0422/DeskTalk/docs/2-外壳设计/各模块的step模型/0-96-oled-display-1.snapshot.1/0.96inch-OLED-Module-D-1.jpg

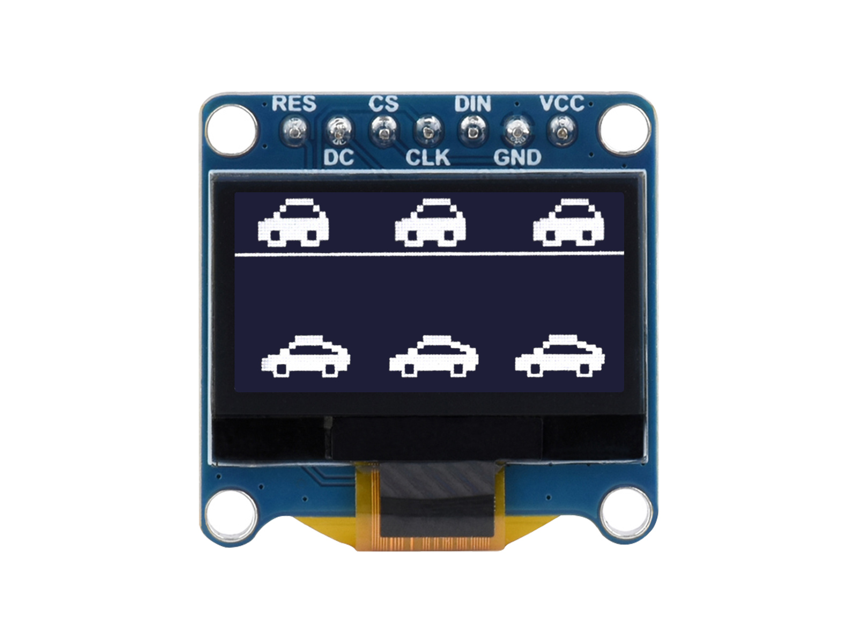
docs/2-外壳设计/各模块的step模型/0-96-oled-display-1.snapshot.1/0.96inch-OLED-Module-D-1.jpg
