0422/DeskTalk/docs/1-固件文档/README.md

# 固件文档

本目录包含 Desk-talk 各版本固件的详细设计说明、优化记录和测试数据。

## 📚 文档清单

| 文档 | 版本 | 框架 | 说明 |
|---|---|---|---|
| [V1说明.md](V1说明.md) | V1 | Arduino | 基础实现，已归档 |
| [V2说明.md](V2说明.md) | V2 | ESP-IDF | V2/desk_talk_idf 完整代码说明（含迁移、功能与测试） |
| [V3：端到端并行架构（规划中）.md](V3：端到端并行架构（规划中）.md) | V3 | ESP-IDF | 端到端并行架构（规划中） |
| [双芯片方案.md](双芯片方案.md) | - | ESP-IDF | ESP32-S3 + C6 双芯片方案架构分析 |

**说明**：
- **V1**：Arduino 框架基础实现，已归档
- **V2说明**：整合原 V2说明.md（功能实现与测试）和 V3说明.md（代码结构与迁移），完整描述 V2/desk_talk_idf 项目
- **V3**：端到端并行架构，规划中

## 🔄 版本总览

版本演进、框架与典型延迟详见 [版本历史.md](../版本历史.md)。

---

> 最后更新：2026-09-22
