0422/DeskTalk/docs/0-硬件文档/README.md

# 硬件文档

本目录包含 Desk-talk 机器人的硬件相关文档，包括物料清单、组装说明、接线图和模块测试。

## 📦 文档清单

| 文档 | 说明 |
|---|---|
| [材料清单.md](材料清单.md) | 物料清单（BOM），列出所有器件和规格 |
| [组装说明.md](组装说明.md) | 组装步骤与注意事项 |
| [接线说明.md](接线说明.md) | 杜邦线接线表（含 GPIO 引脚映射） |
| [模块说明.md](模块说明.md) | 各模块说明与功能测试方法 |

## 📎 附件

- **云台安装教程**：[attachments/0-金属二自由度云台安装教程.pdf](attachments/0-金属二自由度云台安装教程.pdf)
- **参考图片**：[attachments/](attachments/)

## 🔌 器件与引脚

完整器件规格见 [材料清单.md](材料清单.md)，逐线 GPIO 映射见 [接线说明.md](接线说明.md)。

**注意**：当前固件仅使用 INMP441 左声道单麦，右声道硬件已连接但未启用。

---

> 硬件设计基于 [uncle-mark/desk-emoji](https://github.com/uncle-mark/desk-emoji) 项目，感谢原作者。

---

> 最后更新：2026-09-22
