0422/DeskTalk/docs/2-外壳设计/README.md

# 外壳设计

本文档记录 Desk-talk 机器人的外壳结构设计、开孔位置和装配说明。

## 设计背景

在 V1 基础上继续设计与调整机器人外壳结构，以适配屏幕、摄像头、舵机、麦克风和扬声器等硬件布局。

## 结构说明

### 底板与顶板

- **底板 / 顶板**：均为矩形
- **四个角开孔**：孔心间距 76.08 mm，孔半径 1.5 mm

### 顶板居中新孔

1. **云台底座开孔**：长边孔心间距 43.74 mm，短边孔心间距 23.28 mm，孔半径 1.5 mm
2. **麦克风窗口**：10.20 × 10.20 mm
3. **功放露出窗口**：7.70 mm × 7.46 mm
4. **喇叭开孔**：开孔间距 45.5 mm，孔心 3.5 mm（⚠️ 开孔错误待修正）

## 关键器件

| 器件 | 规格 | 备注 |
|---|---|---|
| 喇叭 | 1635 腔体喇叭，20×40 mm，8Ω 2W | 注意正负极 |
| 云台 | 金属二自由度舵机云台 | SG90S × 2 |
| 结构板 | 打印结构板 / 切割亚克力板 | 暂未使用 |

## 待修正

- [ ] 喇叭开孔位置需重新设计（当前开孔有误）
- [ ] 亚克力板切割和装配验证

## 附件

- **STEP 模型**：[各模块的step模型/](各模块的step模型/)
- **FreeCAD 可视化**：[FreeACD组装可视化/](FreeACD组装可视化/)
- **参考图片**：[attachments/](attachments/)

---

> 最后更新：2026-09-22
