0422/DeskTalk/docs/0-硬件文档/接线说明.md

# 汇总说明

当前程序只会采集 L/R=GND 的左麦，右麦不会参与语音识别，可以只插一个麦克风，或修改程序使支持双麦。双麦共用 SD、WS、SCK 的接法本身正确，但并联不会自动获得降噪效果。
> 如果只是给 ASR 录音，建议暂时保留 ONLY_LEFT，使用一个声道最稳妥。
> 如果确实需要两个麦克风同时工作，则还要把输入改为立体声采集、按 INMP441 的 32 位槽读取，再将左右声道混合成 16 位单声道；ASR 当前声明的是单声道，不能只把 ONLY_LEFT 改成 RIGHT_LEFT 就结束。

| 器件 | 线 | ESP32-S3 底板连接 | **备注** |
| --- | --- | --- | --- |
| ==OLED== | GND | 任意 GND | |
| | VCC | 3V3 | |
| | SDA | IO8（GPIO 8） | |
| | SCL | IO9（GPIO 9） | |
| | | | |
| ==X轴舵机（左右）== | 橙/黄，信号 | IO12 的黄色 S 排 | |
| X轴舵机 | 红，电源 | 底板左下角标注 5V 的电源排，或独立 5V 电源 | |
| X轴舵机 | 棕/黑，地 | GND | |
| ==Y轴舵机（上下）== | 橙/黄，信号 | IO13 的黄色 S 排 | |
| Y轴舵机 | 红，电源 | 底板左下角标注 5V 的电源排，或独立 5V 电源 | |
| Y轴舵机 | 棕/黑，地 | GND | |
| | | | |
| ==INMP441 A（左麦）==  | VDD | 3V3 | 必须使用 3.3V 供电 |
| | GND | GND | 与 ESP32-S3、右麦和 MAX98357 共地 |
| | SD (DOUT)  | IO4 (GPIO4) | 与右麦的 SD 并联到同一个 GPIO4 |
| | WS (LRCLK) | IO5 (GPIO5) | 与右麦共用左右声道时钟 |
| | SCK (BCLK) | IO6 (GPIO6) | 与右麦共用位时钟 |
| | L/R | GND | 选择左声道，不能悬空 |
| | | | |
| ==INMP441 B（右麦）==  | VDD | 3V3 | 必须使用 3.3V 供电 |
| | GND | GND | 与 ESP32-S3、左麦和 MAX98357 共地 |
| | SD (DOUT)  | IO4 (GPIO4) | 与左麦的 SD 并联到同一个 GPIO4 |
| | WS (LRCLK) | IO5 (GPIO5) | 与左麦共用左右声道时钟 |
| | SCK (BCLK) | IO6 (GPIO6) | 与左麦共用位时钟 |
| | L/R | 3V3 | 选择右声道，不能悬空 |
| | | | |
| ==MAX98357 功放== | VIN | 5V | 接底板明确标注的 5V 接口 |
| | GND | GND | 与 ESP32-S3、INMP441 共地 |
| | DIN | IO7 (GPIO7) | ESP32-S3 音频数据输出，功放数据输入 |
| | BCLK | IO17 (GPIO17) | 位时钟 |
| | LRC | IO18 (GPIO18) | 左右声道时钟 |
| | GAIN | 悬空或接 MAX98357 的 VIN (5V)  | 悬空为 9 dB；接 VIN (5V) 为 6 dB，不要接 3.3V |
| | SD | GPIO3 | 悬空通常也会保持使能， |
| | | | |
| ==喇叭== | 正极 (+) 红色线 | MAX98357 的 OUT+ | 功放差分输出 |
| | 负极 (-)黑色线  | MAX98357 的 OUT- | 不得接 GND |
| | | | |
| ==PAJ7620U2 手势追踪== | VCC | 3V3 | 还没买，待验证 |
| | GND | GND | |
| | SDA | IO1 (GPIO1) | |
| | SCL | IO2 (GPIO2) | |
| | INT | 悬空，不连接 | |

## ESP32-S3 直连方案
（单麦、无手势追踪），需要从 ESP32-S3 底板上引出的电源数量如下：

| 设备 | 数量 |
|---|---|
| OLED VCC | 1 |
| INMP441 VDD | 1 |
| 合计 | 2 个 3V3 |
两个都是低功耗，ESP32-S3 底板通常只有 **1 个 3V3 排针**，所以你需要**一拖二**，从 3V3 分给 OLED 和单麦。

| 设备 | 数量 | 是否建议走底板 5V |
|---|---|---|
| MAX98357 VIN | 1 | 可以，功放电流中等  |
| X 轴舵机 | 1 | 不建议 |
| Y 轴舵机 | 1 | 不建议 |
| 合计 | 3 个 5V |
底板通常也只有 **1 个 5V 排针**。如果三个都从底板 5V 一拖三：
- MAX98357 功放：中等电流，问题不大
- 两个 MG90 舵机：同时动可能 1A+，**底板 5V 和 USB 供电扛不住**，容易复位

```file:推荐接法
底板 3V3 → 一拖二 → OLED VCC
                  → INMP441 VDD

底板 5V → MAX98357 VIN（功放单独走底板）
独立 5V 电源 → 一拖二 → X 轴舵机红线
                     → Y 轴舵机红线
              └→ GND 与 ESP32 共地
```

| 线 | 用途 | 数量 |
|---|---|---|
| 一拖二杜邦线（母对母） | 3V3 分给 OLED + 麦 | 1 根 |
| 一拖二杜邦线（母对母） | 独立 5V 分给两个舵机 | 1 根 |
| 普通杜邦线 | 5V 给功放 | 1 根 |
| GND 一拖多 | 所有设备共地 | 建议用面包板电源轨 |
