0422/DeskTalk/docs/待开发计划.md

# 今日开发

## 2026-09-22 本轮完成与验证结论

- ✅ `main/llm_client.cpp` 已支持硬标点即时分句，短句不再等待完整 LLM 输出。
- ✅ `main/tts_client.cpp` 已支持句子队列短暂背压、TTS TCP keepalive，以及会话内物理 WebSocket 复用。
- ✅ 多轮日志已出现 `Persistent bidirectional connection reused`，说明 TTS 复用在后续轮次实际生效。
- ⚠️ `400 ms` 静音阈值短停顿测试出现多次前半句截断，已恢复为 `500 ms`；`400 ms` 配置保留为注释供后续对照。
- ⚠️ `session=30` 和 `session=32` 出现 ASR 空结果/串行重试，不能计入正常延迟基线。
- ⏳ LLM HTTPS 长连接仍未实现，当前仍是每轮重新建立 HTTPS 连接。

本轮短停顿日志（`session=22~32`）显示：首轮包含 TTS 预热，后续正常轮次约 `2.2~2.8 s`；重试轮次的延迟按无效样本处理。代码已完成修改，硬件重新编译与烧录由后续测试执行。

---

# 待实现计划
本文档汇总 Desk-talk 当前已知问题、待实现功能和技术债。

---

## 🔴 高优先级

### 1. TTS 连接复用（部分实现）

**问题**：当前每轮对话重建 TTS WebSocket，约 0.6–0.8 秒建连开销。  
**目标**：常驻 TTS 连接，预期降低 ~0.7 秒/轮。  
**当前状态（V2）**：
- ✅ V2 已实现 V3 双向 Session + Session 级物理 WebSocket 复用
- ✅ 唤醒后建立会话级 TTS 连接，后续轮次日志已确认复用成功
- ⚠️ 内部 RAM 水位仍然很低；ASR 空结果、连接异常或会话结束时会释放 TTS 并串行重试
- ⚠️ 复用的是物理 WebSocket，TTS 业务 Session 仍按回答重新开始

**剩余工作**：
- [ ] 评估 ESP-IDF mbedTLS 外部内存 + PSRAM 优化空间，降低复用期间的内存风险
- [ ] 或启用流式网关（仅 V1 工程有实现，V2 未移植），将 TLS 内存压力移至服务器
- [ ] 继续处理 ASR 空结果时的 TTS 释放/重连，减少 `asr_retries=1` 样本
- [ ] 优先解决双 TLS 内存水位问题（测试中 `internal_min` 约为几十字节）

**参考**：[V2说明.md 板载 TLS 内存限制](1-固件文档/V2说明.md#板载-tls-内存限制)

### 2. LLM HTTPS 长连接

**问题**：DeepSeek 每轮从零建连，含 DNS/TCP/TLS 握手约 0.3–1 秒。  
**目标**：复用 HTTP 连接，省去握手开销。  
**当前状态（V2）**：
- ❌ V2说明.md §HTTPS 长连接与双 TLS 危机：LLM 每轮从零建连，无连接复用
- 每轮 `chat()` 执行 `init → perform → cleanup`，无连接复用

**待实现**：
- [ ] 修改 `llm_client.cpp` 设置 `keep_alive_enable=true`
- [ ] handle 提升为成员变量跨轮复用，仅传输错误时重建
- [ ] 验证内部 RAM 水位：常驻 LLM + 常驻 TTS 双连接是否可行

**预期收益**：每轮节省 ~0.5 秒（握手开销）

### 3. VAD 句尾截断验证

**问题**：静音阈值过短可能导致用户短暂停顿被误判为结束。
**目标**：在短停顿场景（如"嗯……"、"就是"）验证识别完整性。  
**方案**：
- [x] 完成一轮 `400 ms` 短停顿试验（`session=22~32`）
- [x] 发现多次前半句截断，确认 `400 ms` 不满足当前拾音条件
- [x] 已将 `main/asr_client.cpp` 恢复为 `500 ms`
- [ ] 使用恢复后的 `500 ms` 再完成 20 轮短停顿 ASR 测试
- [ ] 对比 ASR 最终文本与预期，统计截断率；目标不超过 `5%`

---

## 🟡 中优先级

### 4. 摄像头人脸跟随（已处理，当前禁用）

**现状**：硬件已支持（GC2145 摄像头），V2 明确保持禁用，原因：
- 主 loop 同步推理会阻塞网络任务（500ms/帧）
- 当前固件已验证无需摄像头即可正常运行

**目标**：恢复人脸检测 + 头部跟随，并解决主循环阻塞问题。  
**重新激活前提**：
- [ ] 将 `handle_face_tracking()` 改为独立 FreeRTOS 任务或降低推理频率
- [ ] 验证并发写 GPIO12/13 的舵机抖动问题
- [ ] 验证无人脸时 `random_act()` 能否正常触发（V1 审查"空闲头部僵住"问题）

### 5. 手势传感器（已处理，当前禁用）

**现状**：PAJ7620U2 硬件已列入物料清单，V2 明确保持禁用。代码中有开关但未验证，原因：
- I2C 引脚占用（GPIO1/2）需确认是否与现有外设冲突
- Arduino 库 `RevEng PAJ7620` 在 ESP-IDF 下的兼容性未验证

**目标**：支持 9 种手势识别触发动作。  
**待验证**（重新激活前）：
- [ ] I2C 引脚占用（GPIO1/2）是否与现有外设冲突
- [ ] 在 ESP-IDF 下验证 `RevEng PAJ7620` 库兼容性

### 6. 双麦拾音优化

**现状**：仅使用 INMP441 左声道，右声道并联但未使用。  
**目标**：实现立体声采集 + 软件下混，改善拾音距离和信噪比。  
**方案**：
- [ ] 改为 I2S 立体声模式（`I2S_CHANNEL_FMT_RIGHT_LEFT`）
- [ ] 32-bit 原始数据右移 16 位转 16-bit PCM
- [ ] (L + R) / 2 下混或选择信噪比更优的单声道
- [ ] 实测校准左右声道增益

---

## 🟢 低优先级 / 未来探索

### 7. 配置类功能（多 LLM / 多唤醒词 / 情感驱动动作）

**目标**：支持切换 LLM 供应商、动态增删唤醒词、按情感自动匹配表情动作。  
**状态**：方案细节与代码位置见 [1-固件文档/V2说明.md §待实现功能](1-固件文档/V2说明.md#待实现功能)，此处不再重复。

### 8. 本地离线 TTS

**目标**：断网时仍能回复，降低云端依赖。  
**方案**：
- [ ] 集成 sanoTTS（int8 模型 337 KB，RTF 0.38）
- [ ] 预录音色包（高频应答短语）
- [ ] 网络检测 + 自动降级路由

### 9. LED 亮度自适应

**现状**：WS2812 固定亮度，暗室刺眼。  
**目标**：根据环境光（光敏电阻）或时间自动调节亮度。

---

## 📋 已知技术债

| 问题 | 位置 | 严重性 | 状态 | 备注 |
|---|---|---|---|---|
| 串口日志 256 字节截断中文 | `common.h` 日志器（V1 路径） | 低 | ✅ 已解决（V1） | V1 改为直接输出完整 `String` |
| 舵机并发写抖动 | `act.cpp` + `face_tracking.cpp`（V1 路径） | 中 | ⚠️ 待确认 | V2 未明确提及，舵机功能正常，人脸跟随时需验证 |
| ASR WebSocket 关闭时非致命警告 | `asr_client.cpp` | 低 | ⚠️ 待优化 | 当前判断为关闭握手噪声，可过滤但不影响功能 |
| ASR 空结果触发 TTS 释放/串行重试 | `conversation.cpp` | 中 | ⚠️ 待观察 | `session=30`、`32` 出现空结果；重试成功时不纳入正常延迟基线 |
| 空闲头部僵住（已录入 owner 时） | `face_tracking.cpp:207`（V1 路径） | 低 | ⚠️ 待确认 | V2 摄像头禁用时不适用，恢复人脸跟随后需验证 |
| mbedTLS 工作内存进入 PSRAM | `sdkconfig` | 中 | ⚠️ 待评估 | 正式产品需结合 Flash encryption、Secure Boot 评估 |

---

## 📅 近期里程碑

- [x] **2026-09**：V2 ESP-IDF 迁移完成，8 轮连续对话 + 20 轮延迟统计测试通过
- [x] **2026-09-22**：句子级 LLM→TTS 流式发送、TTS 物理 WebSocket 复用和延迟分阶段日志完成
- [x] **2026-09-22**：完成 `400 ms` VAD 对照测试并确认回退到 `500 ms`
- [ ] **2026-09-22 后续**：完成恢复 `500 ms` 后的 20 轮短停顿复测
- [ ] **2026-Q4**：TTS 连接复用内存优化（双 TLS 共存验证）
- [ ] **2026-Q4**：V3 端到端并行流水线实现（LLM 流式 + 首句触发 TTS）
- [ ] **2027-Q1**：摄像头 + 手势传感器集成（需解决主循环阻塞和引脚冲突）
- [ ] **2027-Q2**：双麦拾音优化 + 本地 TTS 降级

---

> 最后更新：2026-09-22  
> 优先级由项目维护者根据实际使用场景动态调整
