0422/DeskTalk/docs/1-固件文档/V1说明.md

> 备注：因 V2 迁移至 ESP-IDF 框架，V1 版本不再进行修改。

# V1 修改汇总

### 模块开关

原程序只有手势传感器能把 `start_chat` 设置为 true，现在改为了通过唤醒词开启对话。
> 未买入手势追踪模块，将程序中的手势触发停用了，可以通过宏打开。
> 且为方便各模块测试，对麦克风、摄像头、功放、手势追踪等均加了开关，
> 以及某个模块未插到开发板上时，启动时会跳过其初始化环节。

### 离线唤醒词

唤醒识别完全在 ESP32-S3 本地完成，但唤醒后的 ASR、LLM、TTS 仍走现有云端流程。
> 当前流程是半双工的"先听、再回答"，不需要回声消除。
> 若后续要求在机器人说话时也能用语音打断，则需要增加播放中录音、声学回声消除和新的对话状态机。

Arduino ESP32 3.0.0 自带的 WakeNet 模型固定选择 `hi esp`，不能只修改日志文字就变成自定义唤醒词。
改为使用 ESP-SR 自带的英文 MultiNet 命令检测，并把默认的 Hi ESP 短语和新增的唤醒词短语注册为同一个命令。
> MultiNet 自定义命令不是专门训练的 WakeNet 模型，短语识别效果和抗误唤醒能力可能与 ESP-SR 固定的 WakeNet 模型不同。

增加本地唤醒词 `Hi ESP` 和 `Hi Della`，唤醒后进入最长 10 分钟的连续对话窗口，避免每一轮对话都要重新唤醒。
> 唤醒后，主程序会暂停本地 MultiNet，避免它和云端 ASR 同时读取同一个 I2S 麦克风；
> 云端 ASR 结束后再恢复 MultiNet。
> 恢复时会清空待处理事件，并加入短暂冷却时间，避免上一段语音残留导致重复唤醒。

### DeepSeek 直连与多轮对话

- LLM 从第三方中转站迁移到 DeepSeek 官方 `https://api.deepseek.com/chat/completions`，使用 `deepseek-flash` 模型，减少中转服务不可达导致的连接失败。
- 请求使用非流式 JSON 输出、关闭思考模式并限制最大输出长度；回复从 `choices[0].message.content` 中解析。
- 对网络传输错误、HTTP 408、429 和 5xx 响应增加最多 3 次重试。
- ESP32-S3 在 SPIFFS 的 `/chat_history.json` 中保存上下文，每次请求携带系统提示词、历史用户/助手消息及本轮问题，实现多轮对话。
- 历史记录最多保留 10 轮、限制为 16 KiB；无效、不完整或过大的历史文件会自动重置。
- DeepSeek 密钥改由被 Git 忽略的 `secrets.h` 提供，并增加 `secrets.example.h`，不再把旧中转站密钥写在业务源码中。

### TTS 长回复与音频播放

- TTS WebSocket 回调只复制并排队 PCM，由独立 FreeRTOS 任务执行阻塞式 I2S 播放，防止播放过程阻塞后续网络收包。
- 有 PSRAM 时使用 48 个 PCM 队列槽，无 PSRAM 时使用 8 个；队列分片使用独立内存，播放后及时释放。
- 将长回复按完整句子拆为不超过约 120 个 UTF-8 字节的小段并逐段合成，切分时不破坏中文字符，避免服务端只生成长文本前半部分。
- 服务端在收到 PCM 后正常关闭连接时按流结束处理，并在播放队列完全排空后结束，不再把正常关闭误判为失败。
- 多段播放期间保持 MAX98357 功放开启；整条回复结束后等待 I2S DMA 中最多约 512 ms 的剩余音频播放完再静音，修复段尾吞字。
- 修正成功收到 PCM 时仍输出 `returned no PCM audio` 的错误判断，并记录每段文本长度、PCM 字节数和待播放分片数。

### 动作数量与舵机稳定性

- 删除 TTS 播放期间每 3 秒触发的随机语音动作，避免动作任务频繁打断音频和网络处理。
- 提示词将每次回复动作减少为 2～3 个，执行端再硬限制最多执行 3 个动作。
- 空闲随机行为不再自动驱动左右舵机，只保留不会抢占头部控制权的表情行为，降低底部舵机长时间通电后连续旋转的概率。
- 对话期间暂停人脸跟随，完成 ASR、LLM、动作和 TTS 后再恢复，避免多个功能同时控制头部舵机。

### Wi-Fi 连接与配网

- Wi-Fi 凭据优先保存到 NVS，并保留 SPIFFS 配置文件作为旧版本迁移和兼容备份；断线后在主循环中非阻塞重连。
- 配网模式明确使用 `WIFI_AP_STA`，使 `Desk-Emoji`（配网热点名）和附近网络扫描能够同时工作。
- 检查 SoftAP 启动结果及 `192.168.4.1` 地址；扫描失败时清理状态并自动重试一次，不再把扫描错误显示成"未找到网络"。
- 扫描接口增加错误码日志和合法 JSON 转义，网页能显示真实扫描失败原因。
- 默认联网目标改为开放网络 `Longemont`，密码为空；启动连接、断线重连和 NVS 保存均支持无密码 Wi-Fi。

### 串口日志与诊断

- `Bot:` 回复改为直接输出完整 `String`，绕过原日志器 256 字节格式化缓冲区，解决中文 JSON 在串口中只显示前半段并以乱码字符结尾的问题。
- Wi-Fi 日志增加 SSID、连接状态名称、SoftAP 地址和扫描结果；ASR、TTS 日志增加连接尝试、超时、PCM 接收量及播放完成状态，方便区分公网故障、服务端断开与本地播放问题。
- 对 ASR WebSocket 增加连接重试、超时和连接状态日志，能够区分 Wi-Fi 断开与云端 TLS/WebSocket 握手失败。

## 延迟基线说明

V1 阶段的延迟测量主要关注"说完话后到首音频播放"的端到端延迟，使用 `latency_trace` 记录 9 个阶段时间戳。

**典型耗时范围**（V1 初期样本）：
- `AUDIO_UPLOAD_DONE → PLAYBACK_START`：约 2.47–2.76 秒
- ASR 最终结果：约 0.11–0.29 秒
- LLM 首字节：约 0.55–1.13 秒
- TTS 建连：约 0.63–0.67 秒
- TTS 首 PCM：约 0.29–0.40 秒

**优化后**（V1 后期优化实施后）：
- VAD 静默等待：900ms → 650ms → 500ms
- DeepSeek 改为 SSE 增量接收
- TTS 独立播放任务 + PCM 队列
- 可选流式网关（默认关闭）
- 典型说完后延迟：约 2.377–2.874 秒

**关键瓶颈**：
- TTS 每轮新建 WebSocket，约 0.6–0.8 秒建连开销
- LLM 等待完整 JSON 后才触发 TTS
- 云服务生成和网络抖动

**迁移 ESP-IDF 预期**：
- 纯框架迁移可降低约 50–200 ms
- 结合连接复用和流水线优化可达到约 1.3–1.8 秒
- 稳定低于 1 秒需本地 ASR / WebRTC 类方案

## 移至 V2/V3 的功能

以下功能在 V1 阶段未完成或仅部分实现，移至后续版本：

- [x] **V2**：ESP-IDF 框架迁移（任务调度、PSRAM、mbedTLS 优化）
- [x] **V2**：TTS V3 双向接口 + 连接复用
- [x] **V2**：LLM 流式输出（SSE 增量接收）
- [ ] **V3**：首句立即触发 TTS + 端到端并行流水线（LLM 生成与 TTS 合成重叠）

## 待优化方向（V1 阶段提出，后续持续跟进）

1. **音频流控和流水线**：实现 LLM 流式输出 + 首句触发 TTS
2. **连接复用**：TTS WebSocket 长连接 + LLM HTTPS 长连接
3. **传输协议评估**：MQTT+UDP（低延迟弱网差）vs WebSocket（稳定）
4. **本地降级**：断网时离线命令识别 + 本地 TTS
5. **多唤醒词配置化**：动态增删无需重新编译

---

> 本文档已精简；V2 的测试数据与延迟拆解见 [V2说明.md](V2说明.md)。
> 原 Arduino 工程目录：`V1/Arduino_esp32s3_v0.0.1/Arduino_esp32s3_v0.0.1/`
> 最后更新：2026-09-22
