0422/DeskTalk/docs/0-硬件文档/attachments/ChatGPT Image 2026年9月8日 15_35_54.png

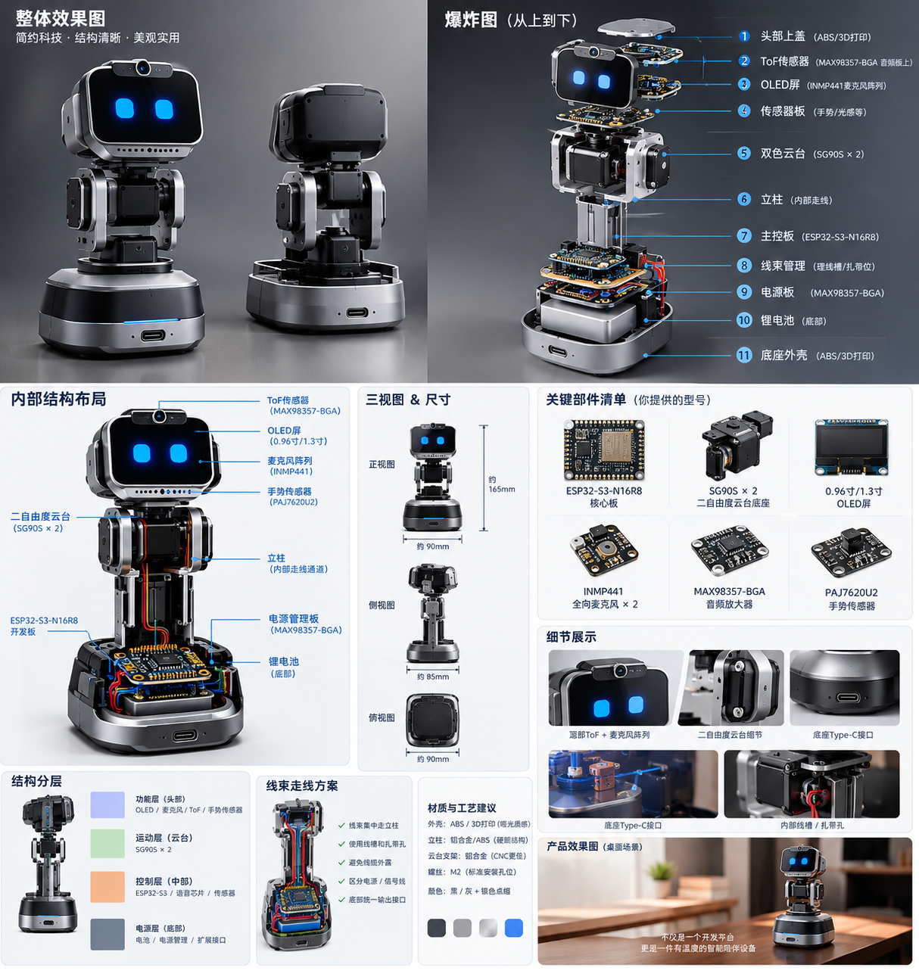
docs/0-硬件文档/attachments/ChatGPT Image 2026年9月8日 15_35_54.png
