0422/DeskTalk/docs/0-硬件文档/attachments/Pasted image 20260820151540.png

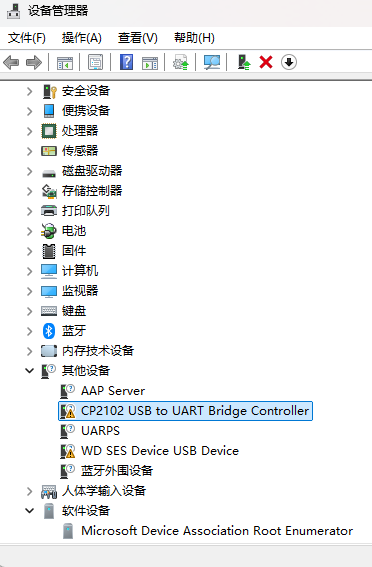
docs/0-硬件文档/attachments/Pasted image 20260820151540.png
