0422/DeskTalk/docs/0-硬件文档/attachments/Pasted image 20260912190659.png

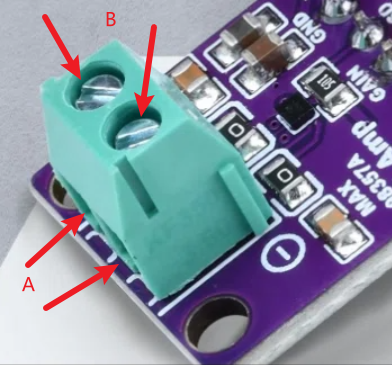
docs/0-硬件文档/attachments/Pasted image 20260912190659.png
