0422/DeskTalk/docs/2-外壳设计/attachments/acrylic_plates_cad_preview.png

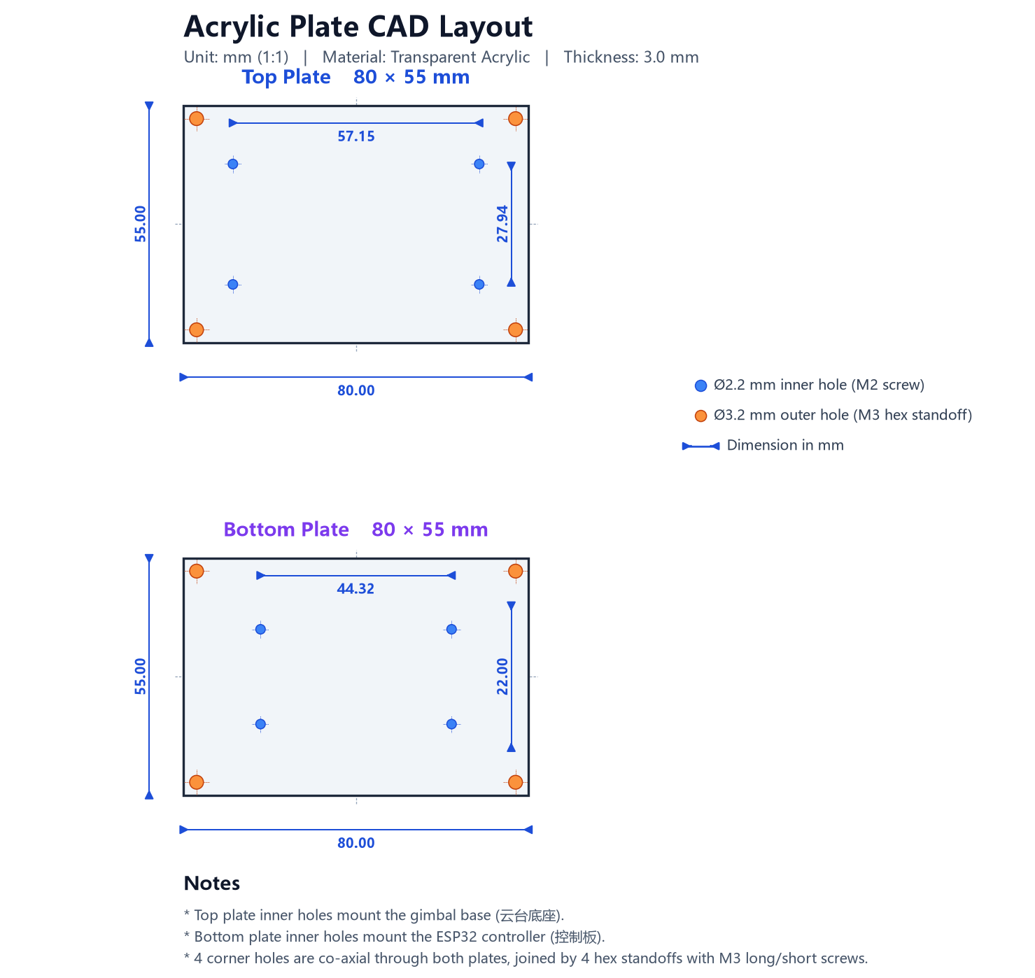
docs/2-外壳设计/attachments/acrylic_plates_cad_preview.png
