0422/DeskTalk/docs/2-外壳设计/attachments/Pasted image 20260916230812.png

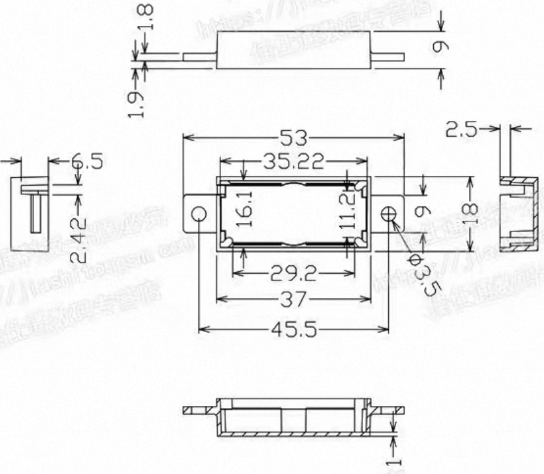
docs/2-外壳设计/attachments/Pasted image 20260916230812.png
