0422/DeskTalk/docs/0-硬件文档/材料清单.md

【已使用】
ESP32-S3-N16R8
ESP32-S3 GPIO Extension Board
INMP441全向麦克风
MAX98357-BGA音频放大器
2W 8欧 喇叭

金属二自由度云台（舵机 `SG90S` * 2 ）
OLED 屏，0.96 寸/1.3 寸
杜邦线若干

---
【暂未使用】
打印结构板/切割亚克力板
手势传感器  PAJ7620U2
摄像头模块 TX-G 2145-V 1.0

## 参考文档

- **云台组装**：见 [attachments/0-金属二自由度云台安装教程.pdf](attachments/0-金属二自由度云台安装教程.pdf)
- **接线说明**：[接线说明.md](接线说明.md)
- **模块测试**：[模块说明.md](模块说明.md)
- **烧录流程**：[../3-开发流程/烧录说明.md](../3-开发流程/烧录说明.md)

---

> 最后更新：2026-09-22
