0422/DeskTalk/docs/2-外壳设计/各模块的step模型/舵机云台/舵机云台_爱给网_aigei_com/舵机云台/舵机卡.SLDASM

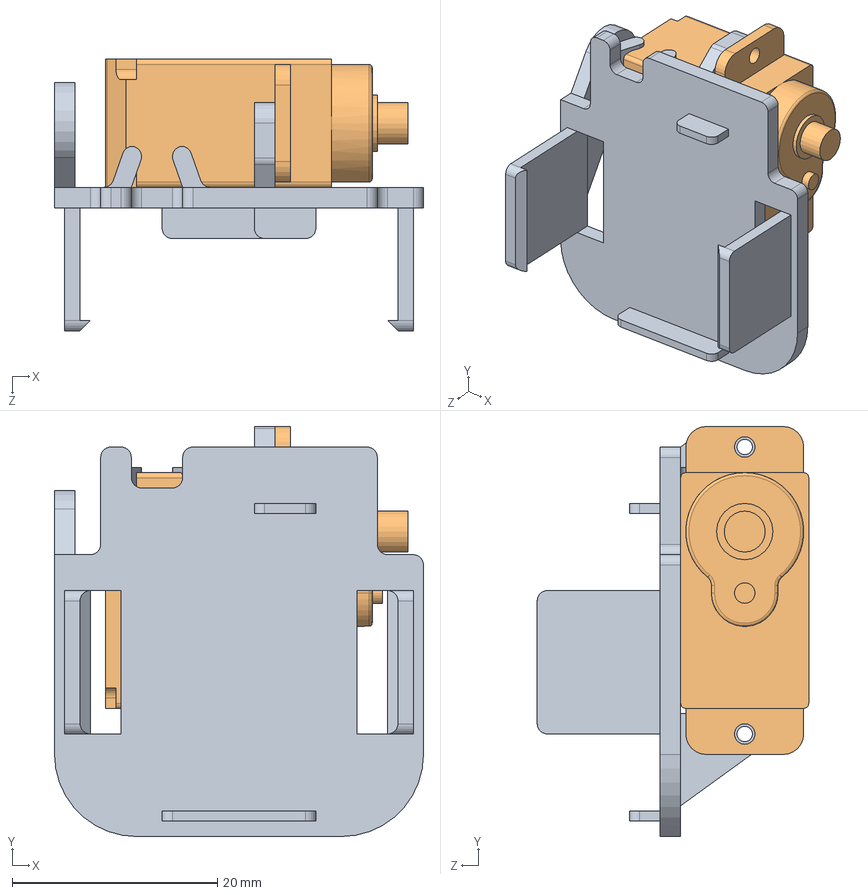
[picture p10: CAD file, 2026-09-18]
docs/2-外壳设计/各模块的step模型/舵机云台/舵机云台_爱给网_aigei_com/舵机云台/舵机卡.SLDASM
36.0 x 40.0 x 26.5 mm
卡壳
9G舵机
