0422/DeskTalk/docs/2-外壳设计/各模块的step模型/舵机云台/舵机云台_爱给网_aigei_com/舵机云台/舵机云台.SLDASM

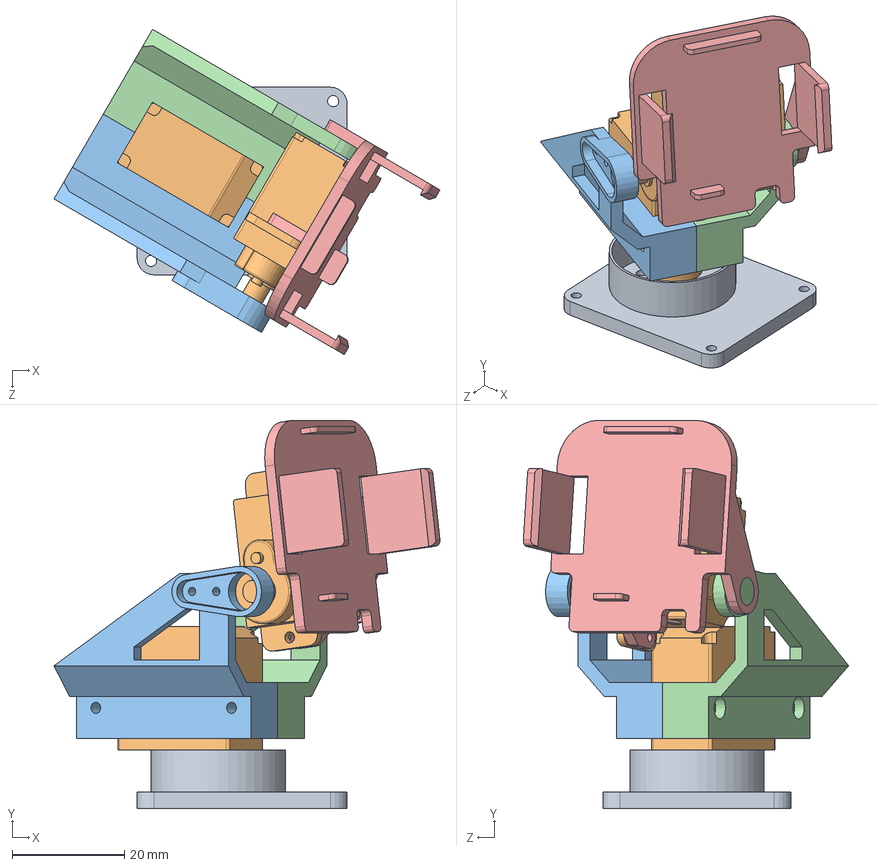
[picture p11: CAD file, 2026-09-18]
docs/2-外壳设计/各模块的step模型/舵机云台/舵机云台_爱给网_aigei_com/舵机云台/舵机云台.SLDASM
68.9 x 69.3 x 58.1 mm
底座
9G舵机 x 2
右臂
左臂
卡壳
