0422/DeskTalk/docs/2-外壳设计/各模块的step模型/舵机云台/舵机云台_爱给网_aigei_com/舵机云台/舵机臂.SLDASM

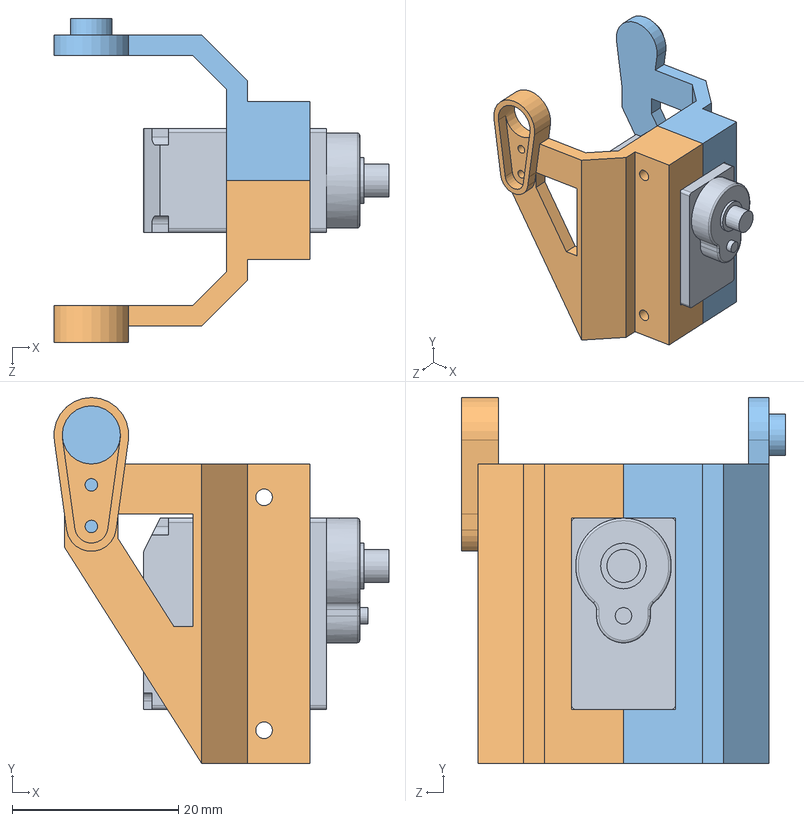
[picture p12: CAD file, 2026-09-18]
docs/2-外壳设计/各模块的step模型/舵机云台/舵机云台_爱给网_aigei_com/舵机云台/舵机臂.SLDASM
40.2 x 44.0 x 39.0 mm
9G舵机
右臂
左臂
