0422/DeskTalk/docs/2-外壳设计/各模块的step模型/0-96-oled-display-1.snapshot.1/0,96'' OLED Display.step

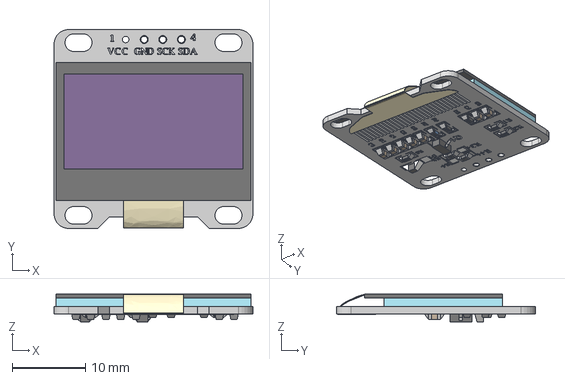
[picture p15: CAD file, 2026-09-18]
docs/2-外壳设计/各模块的step模型/0-96-oled-display-1.snapshot.1/0,96'' OLED Display.step
27.2 x 27.2 x 3.79 mm
