0422/DeskTalk/docs/2-外壳设计/各模块的step模型/inmp441-microphone-module-1.snapshot.2/INMP441 I2S Microphone.STEP

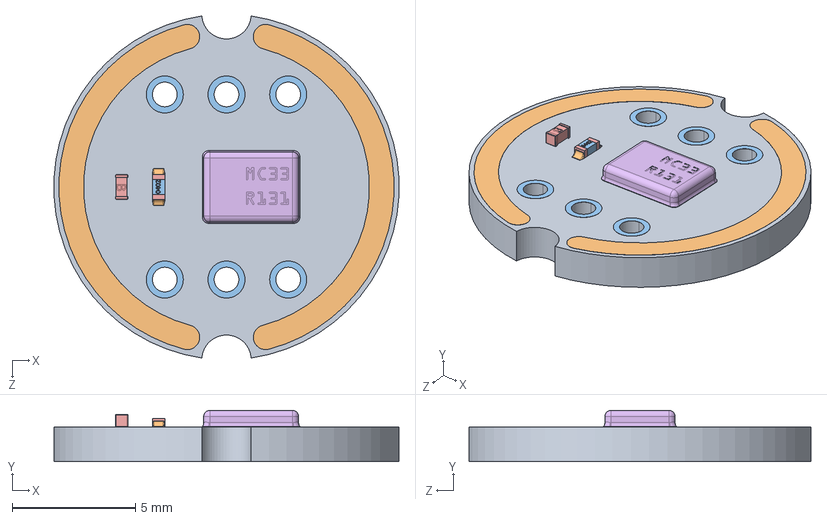
[picture p16: CAD file, 2026-09-18]
docs/2-外壳设计/各模块的step模型/inmp441-microphone-module-1.snapshot.2/INMP441 I2S Microphone.STEP
14.0 x 2.08 x 13.9 mm
