0422/DeskTalk/docs/2-外壳设计/各模块的step模型/paj7620u2-1.snapshot.7/PAJ7620U2.STEP

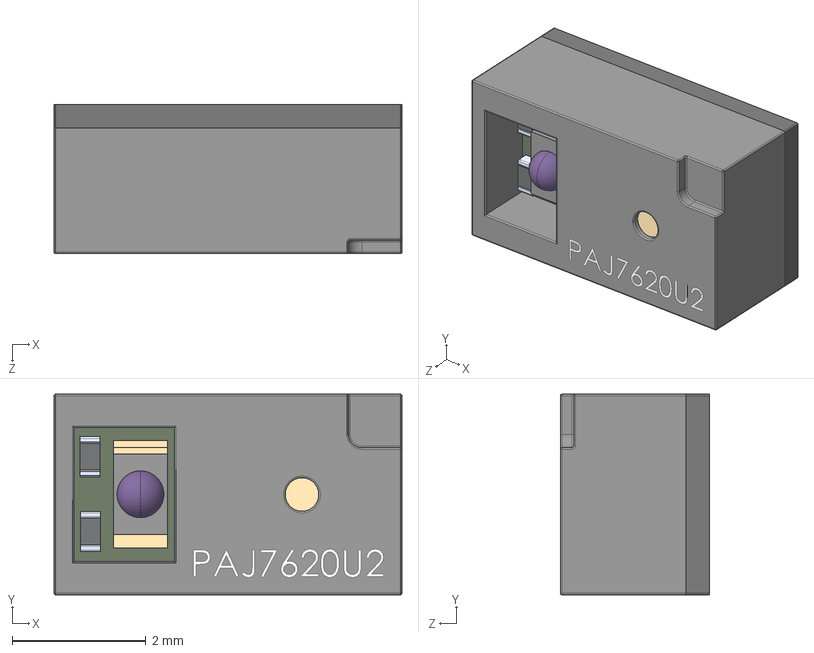
[picture p17: CAD file, 2026-09-18]
docs/2-外壳设计/各模块的step模型/paj7620u2-1.snapshot.7/PAJ7620U2.STEP
5.20 x 3.00 x 2.23 mm
PAJ7620U2
PAJ7620U2_R0201 x 2
0603_2.stp
0603_3.stp
0603_8.stp
0603_9.stp
0603_12.stp
0603_13.stp
0603_14.stp
0603_4.stp
0603_5.stp
0603_6.stp
0603_10.stp
0603_15.stp
