0422/DeskTalk/docs/2-外壳设计/各模块的step模型/发言者2040 8 欧姆2 瓦特/Speaker 2040 8Ohm 2W.stp

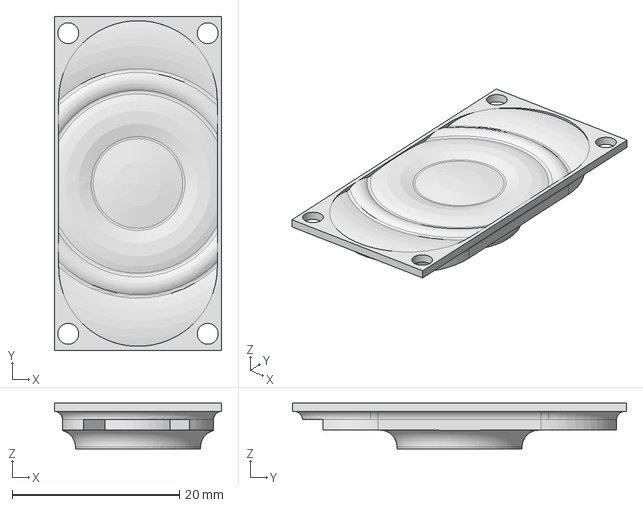
[picture p19: CAD file, 2026-09-18]
docs/2-外壳设计/各模块的step模型/发言者2040 8 欧姆2 瓦特/Speaker 2040 8Ohm 2W.stp
20.0 x 40.0 x 5.50 mm
