0422/DeskTalk/docs/2-外壳设计/各模块的step模型/舵机云台/9G舵机.STEP

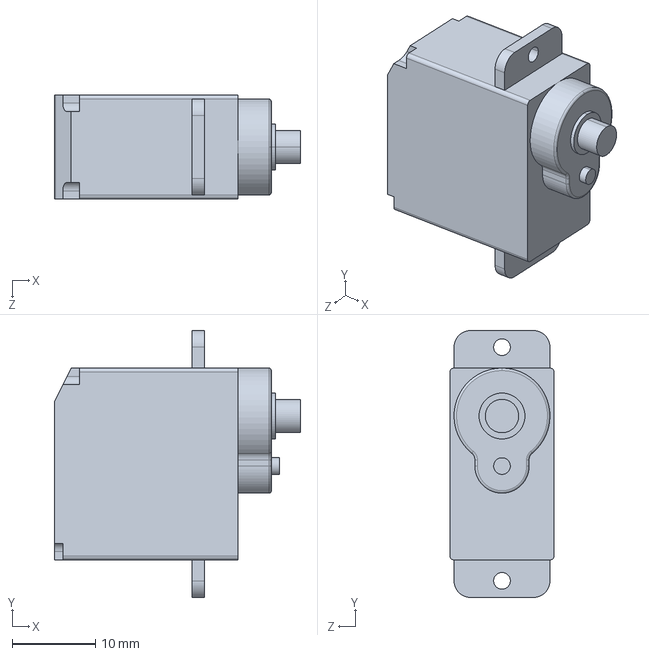
[picture p20: CAD file, 2026-09-18]
docs/2-外壳设计/各模块的step模型/舵机云台/9G舵机.STEP
29.5 x 32.0 x 12.5 mm
