0422/DeskTalk/docs/2-外壳设计/各模块的step模型/舵机云台/舵机云台_爱给网_aigei_com/舵机云台/9G舵机.SLDPRT

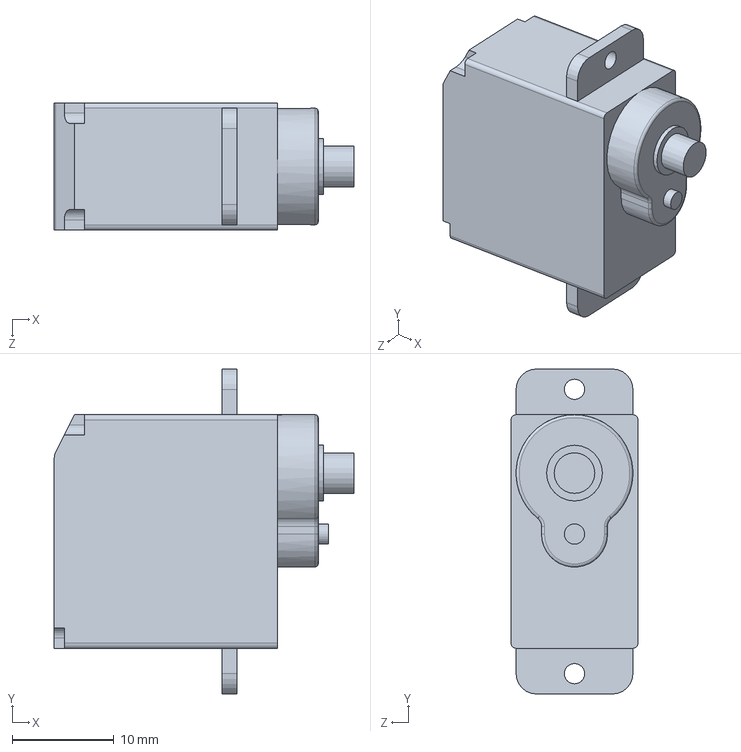
[picture p21: CAD file, 2026-09-18]
docs/2-外壳设计/各模块的step模型/舵机云台/舵机云台_爱给网_aigei_com/舵机云台/9G舵机.SLDPRT
29.5 x 32.0 x 12.5 mm
