0422/DeskTalk/docs/2-外壳设计/各模块的step模型/螺丝和螺母/M2/M2.STEP

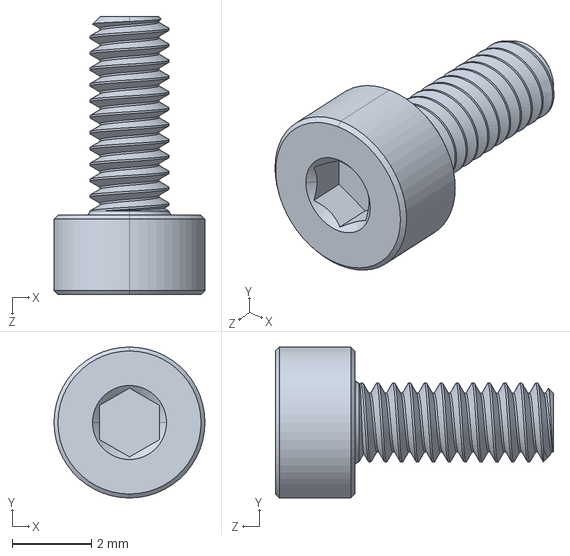
[picture p22: CAD file, 2026-09-18]
docs/2-外壳设计/各模块的step模型/螺丝和螺母/M2/M2.STEP
3.80 x 3.80 x 7.00 mm
