0422/DeskTalk/docs/2-外壳设计/attachments/top_plate.dxf

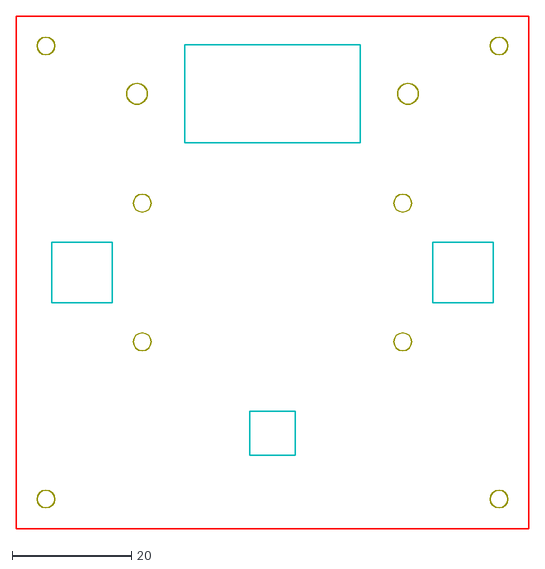
[picture p23: CAD file, 2026-09-18]
docs/2-外壳设计/attachments/top_plate.dxf
86.1 x 86.1
