0422/DeskTalk/docs/2-外壳设计/各模块的step模型/舵机云台/左臂.STEP

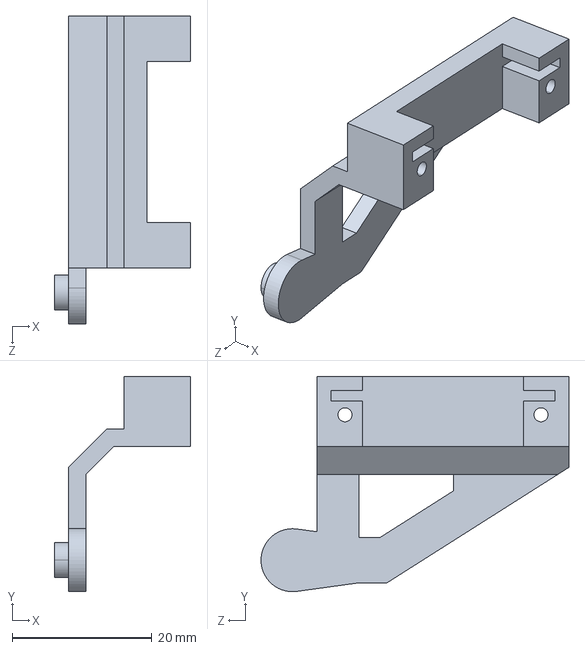
[picture p26: CAD file, 2026-09-18]
docs/2-外壳设计/各模块的step模型/舵机云台/左臂.STEP
19.5 x 30.8 x 44.0 mm
