0422/DeskTalk/docs/2-外壳设计/各模块的step模型/舵机云台/舵机云台_爱给网_aigei_com/舵机云台/左臂.SLDPRT

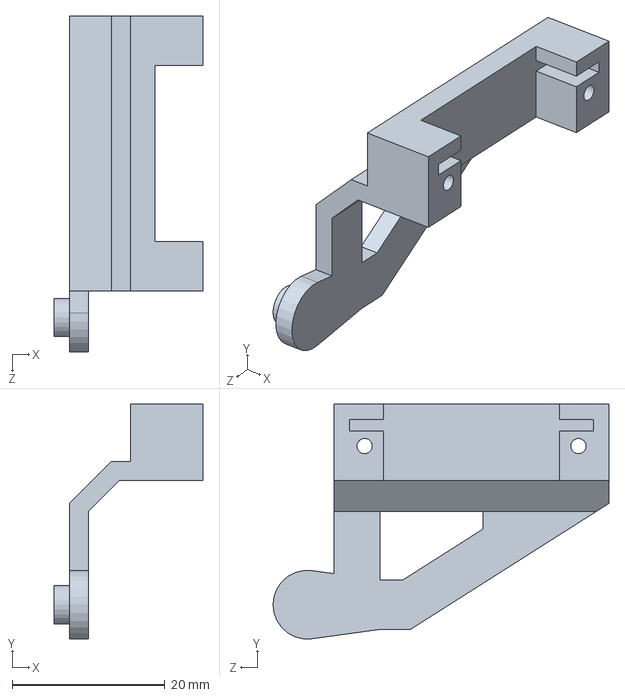
[picture p27: CAD file, 2026-09-18]
docs/2-外壳设计/各模块的step模型/舵机云台/舵机云台_爱给网_aigei_com/舵机云台/左臂.SLDPRT
19.5 x 30.7 x 44.0 mm
