0422/DeskTalk/docs/2-外壳设计/各模块的step模型/舵机云台/卡壳.STEP

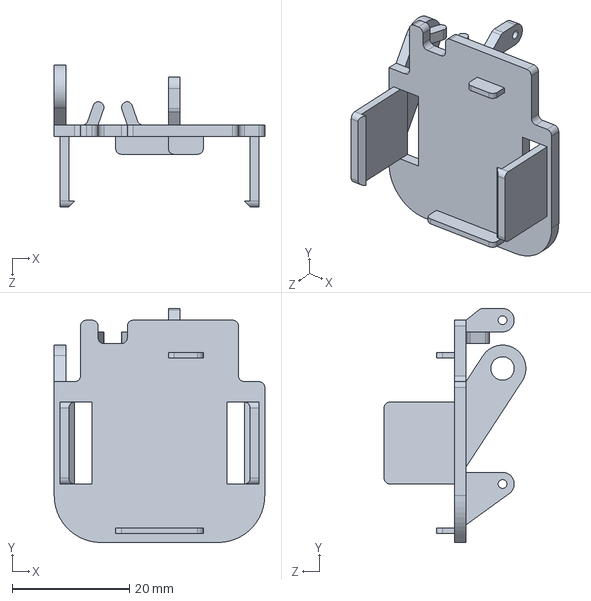
[picture p29: CAD file, 2026-09-18]
docs/2-外壳设计/各模块的step模型/舵机云台/卡壳.STEP
36.0 x 40.0 x 24.2 mm
