0422/DeskTalk/(list of files, cad)

Other CAD files:
docs/2-外壳设计/各模块的step模型/舵机云台/舵机臂.STEP
docs/2-外壳设计/各模块的step模型/舵机云台/舵机云台.STEP
docs/2-外壳设计/各模块的step模型/舵机云台/舵机卡.STEP
docs/2-外壳设计/各模块的step模型/舵机云台/底座.STEP
docs/2-外壳设计/各模块的step模型/舵机云台/舵机云台_爱给网_aigei_com/舵机云台/卡壳.SLDPRT
docs/2-外壳设计/各模块的step模型/inmp441-microphone-module-1.snapshot.2/INMP441 I2S Microphone.SLDPRT
docs/2-外壳设计/各模块的step模型/max98357a功放/MAX98357A_3W_I2S_AMP v27.step
docs/2-外壳设计/各模块的step模型/发言者2040 8 欧姆2 瓦特/Speaker 2040 8Ohm 2W.ipt
