0422/DeskTalk/docs/2-外壳设计/FreeACD组装可视化/desk-talk-3d-preview.html

# desk-talk 整机 3D 预览

99 × 78 × 44mm · 层间距 36mm · 四角铜柱 · 单左侧板嵌喇叭 · 前后开放

云台偏航0°

云台俯仰0°

爆炸视图0%

揭顶 自动旋转 标签 重置视角

左键拖拽旋转 · 滚轮缩放 · 右键平移

3D 资源加载失败，请检查网络后刷新。
