0422/DeskTalk/docs/2-外壳设计/各模块的step模型/ESP32-S3扩展板/ESP32-s3 Expansion Board.png

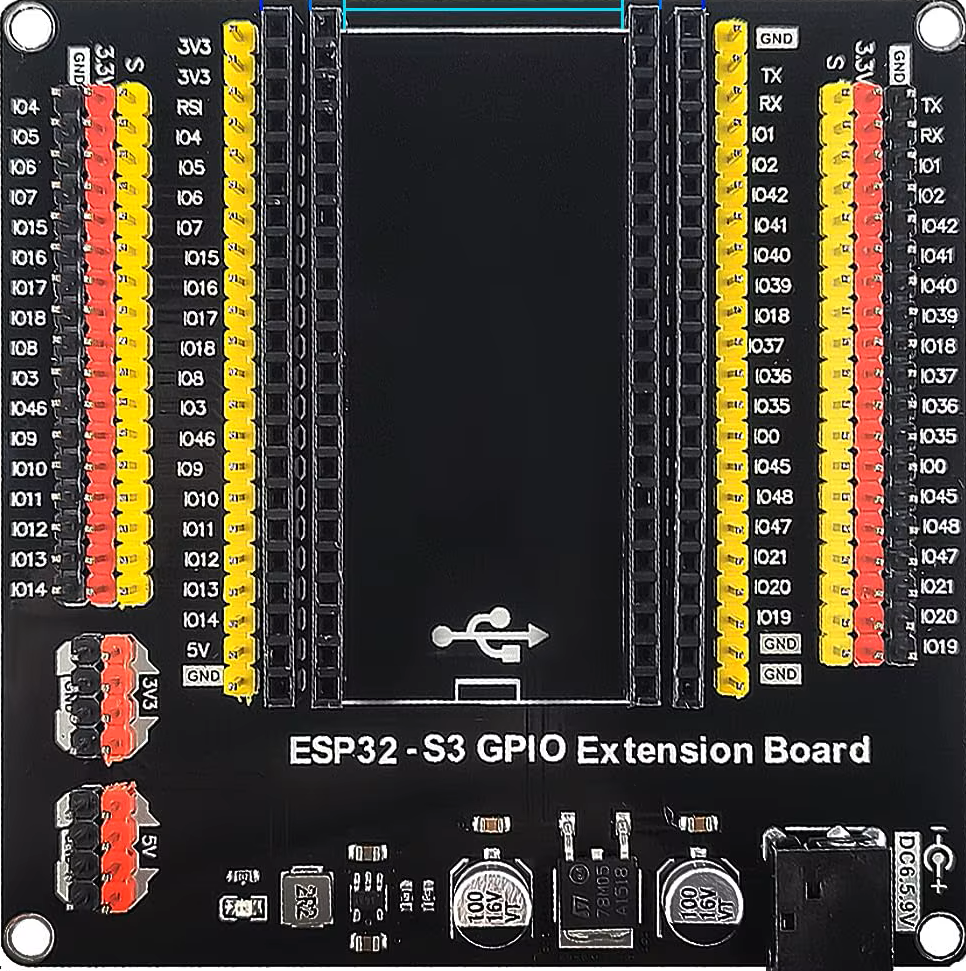
docs/2-外壳设计/各模块的step模型/ESP32-S3扩展板/ESP32-s3 Expansion Board.png
