0422/DeskTalk/docs/2-外壳设计/各模块的step模型/inmp441-microphone-module-1.snapshot.2/INMP441 (2).jpg

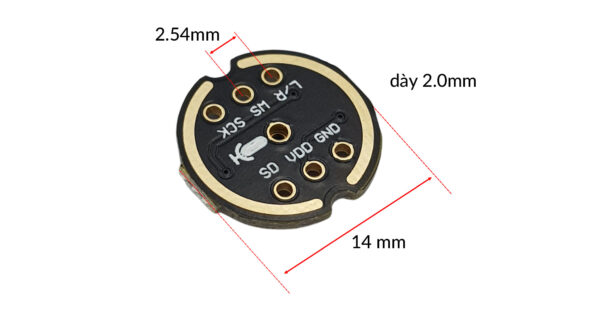
docs/2-外壳设计/各模块的step模型/inmp441-microphone-module-1.snapshot.2/INMP441 (2).jpg
