0422/DeskTalk/docs/2-外壳设计/各模块的step模型/max98357a功放/MAX98357A_3.png

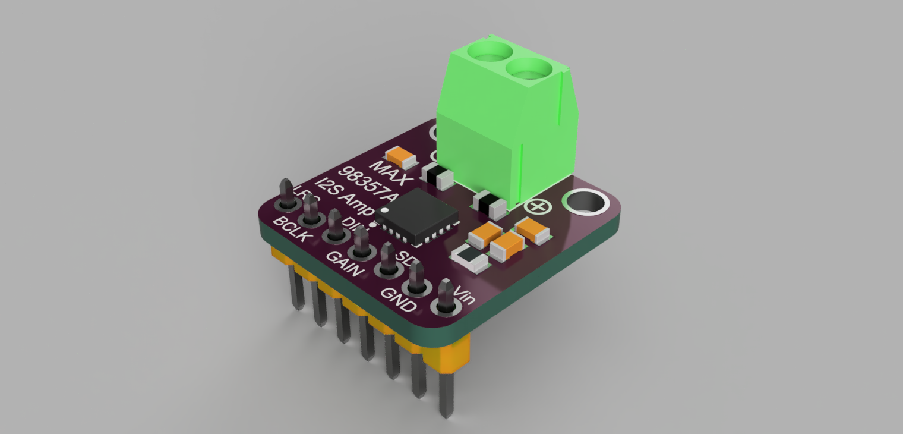
docs/2-外壳设计/各模块的step模型/max98357a功放/MAX98357A_3.png
