0422/DeskTalk/docs/2-外壳设计/各模块的step模型/zsp32-s3-wroom-1-devkit-1.snapshot.9/ESP32-S3-WROOM-1_view1.png

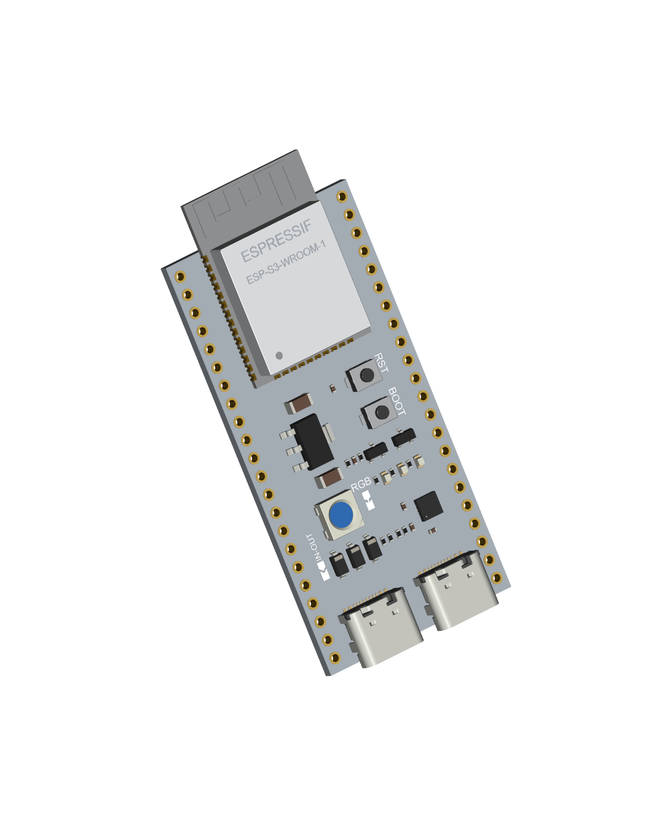
docs/2-外壳设计/各模块的step模型/zsp32-s3-wroom-1-devkit-1.snapshot.9/ESP32-S3-WROOM-1_view1.png
