0422/DeskTalk/docs/2-外壳设计/各模块的step模型/发言者2040 8 欧姆2 瓦特/Speaker 2040 8Ohm 2W.png

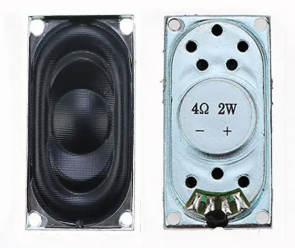
docs/2-外壳设计/各模块的step模型/发言者2040 8 欧姆2 瓦特/Speaker 2040 8Ohm 2W.png
