0422/DeskTalk/docs/2-外壳设计/attachments/亚克力切割图纸（顶板和底板）.pdf

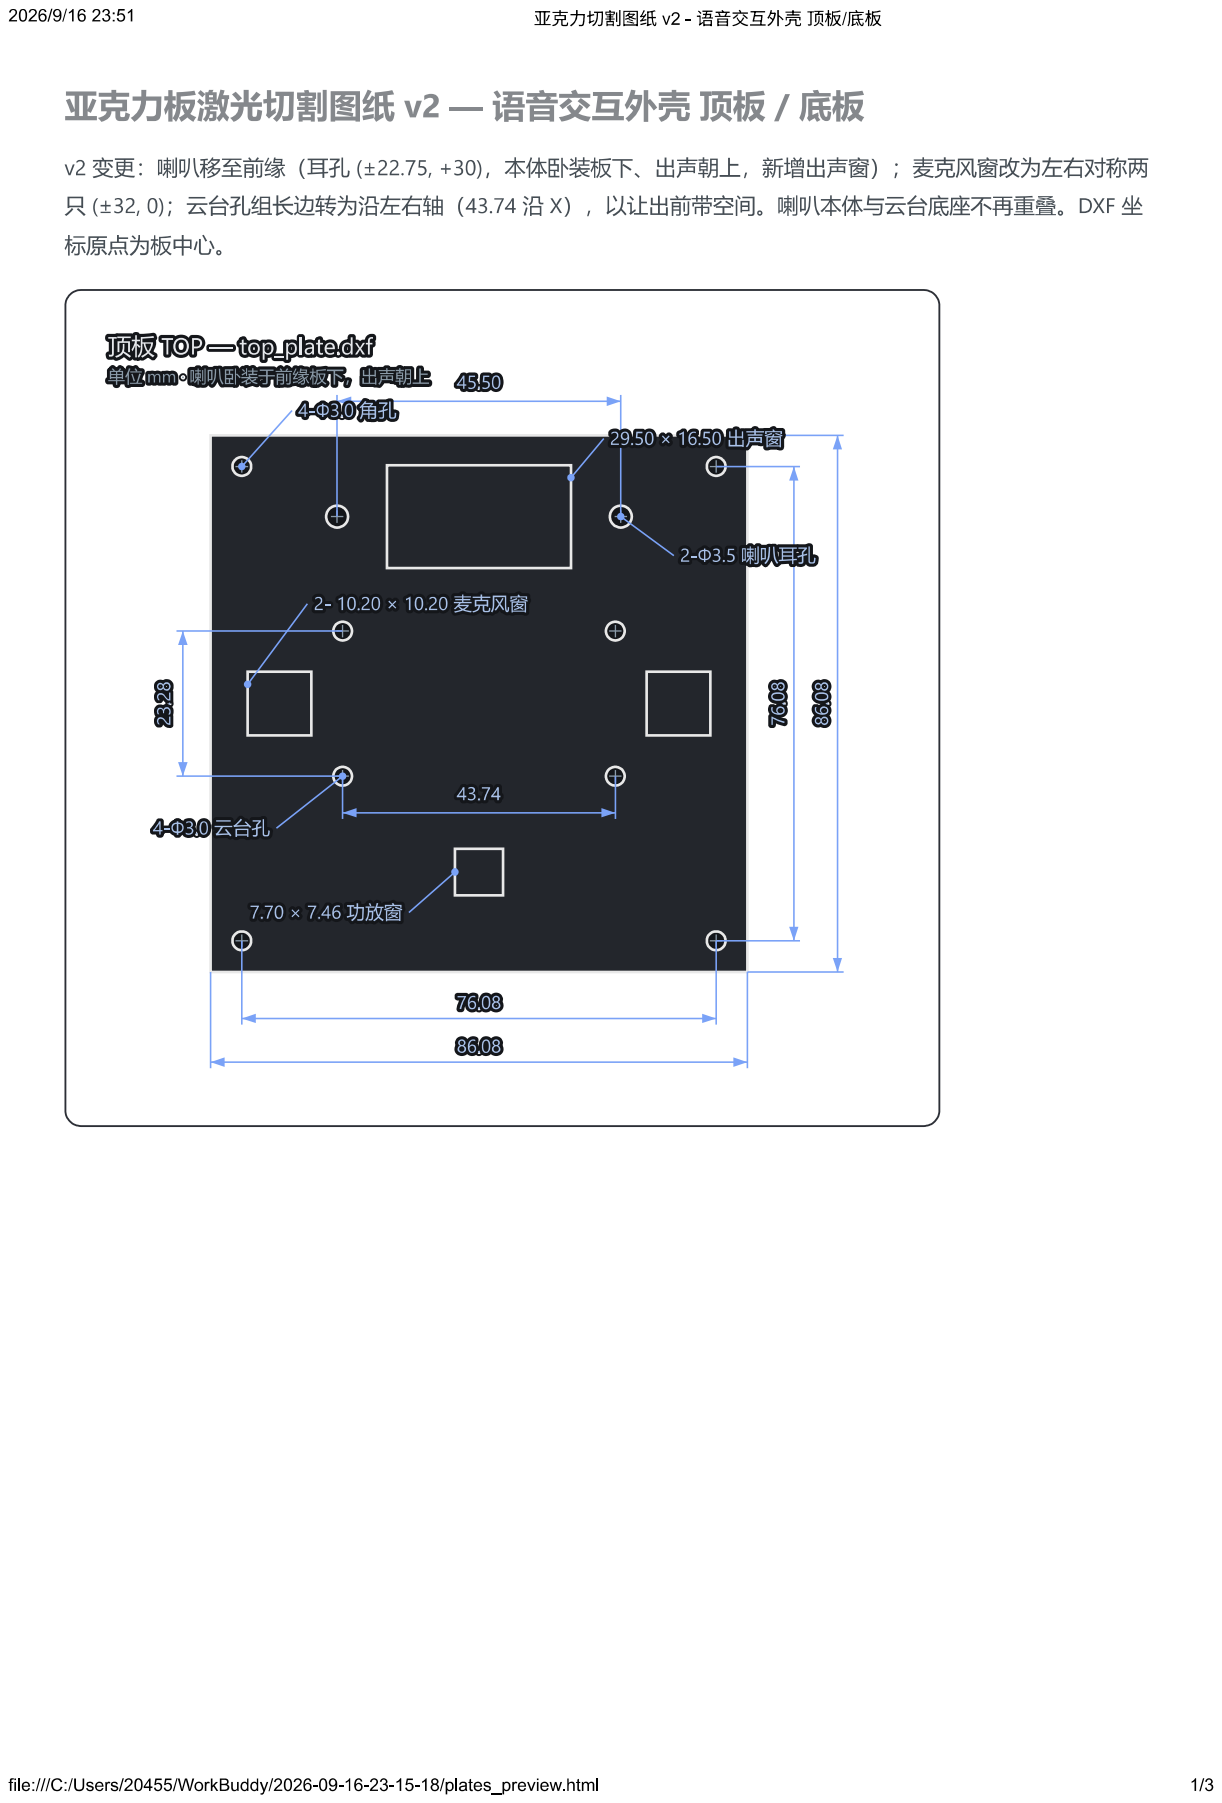
[picture p41: page 1]

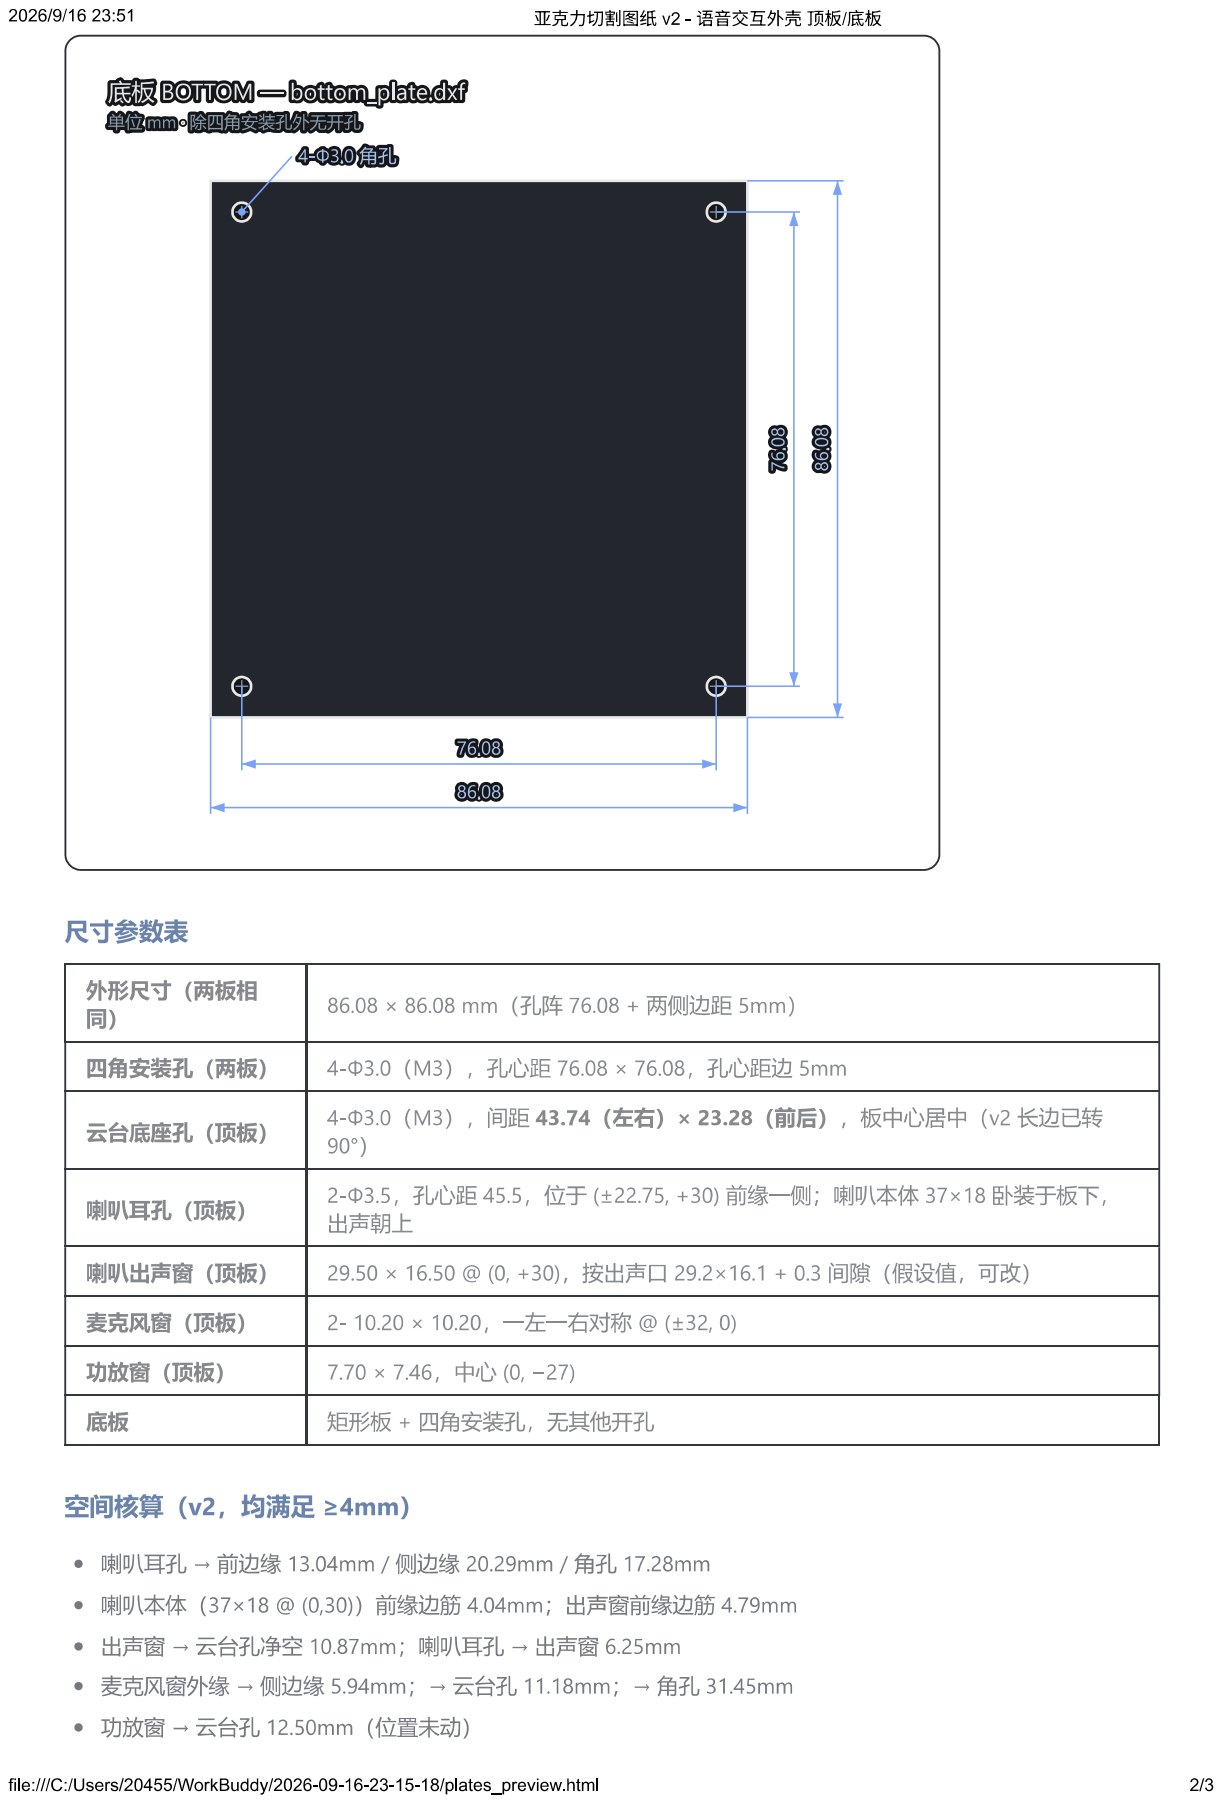
[picture p42: page 2]

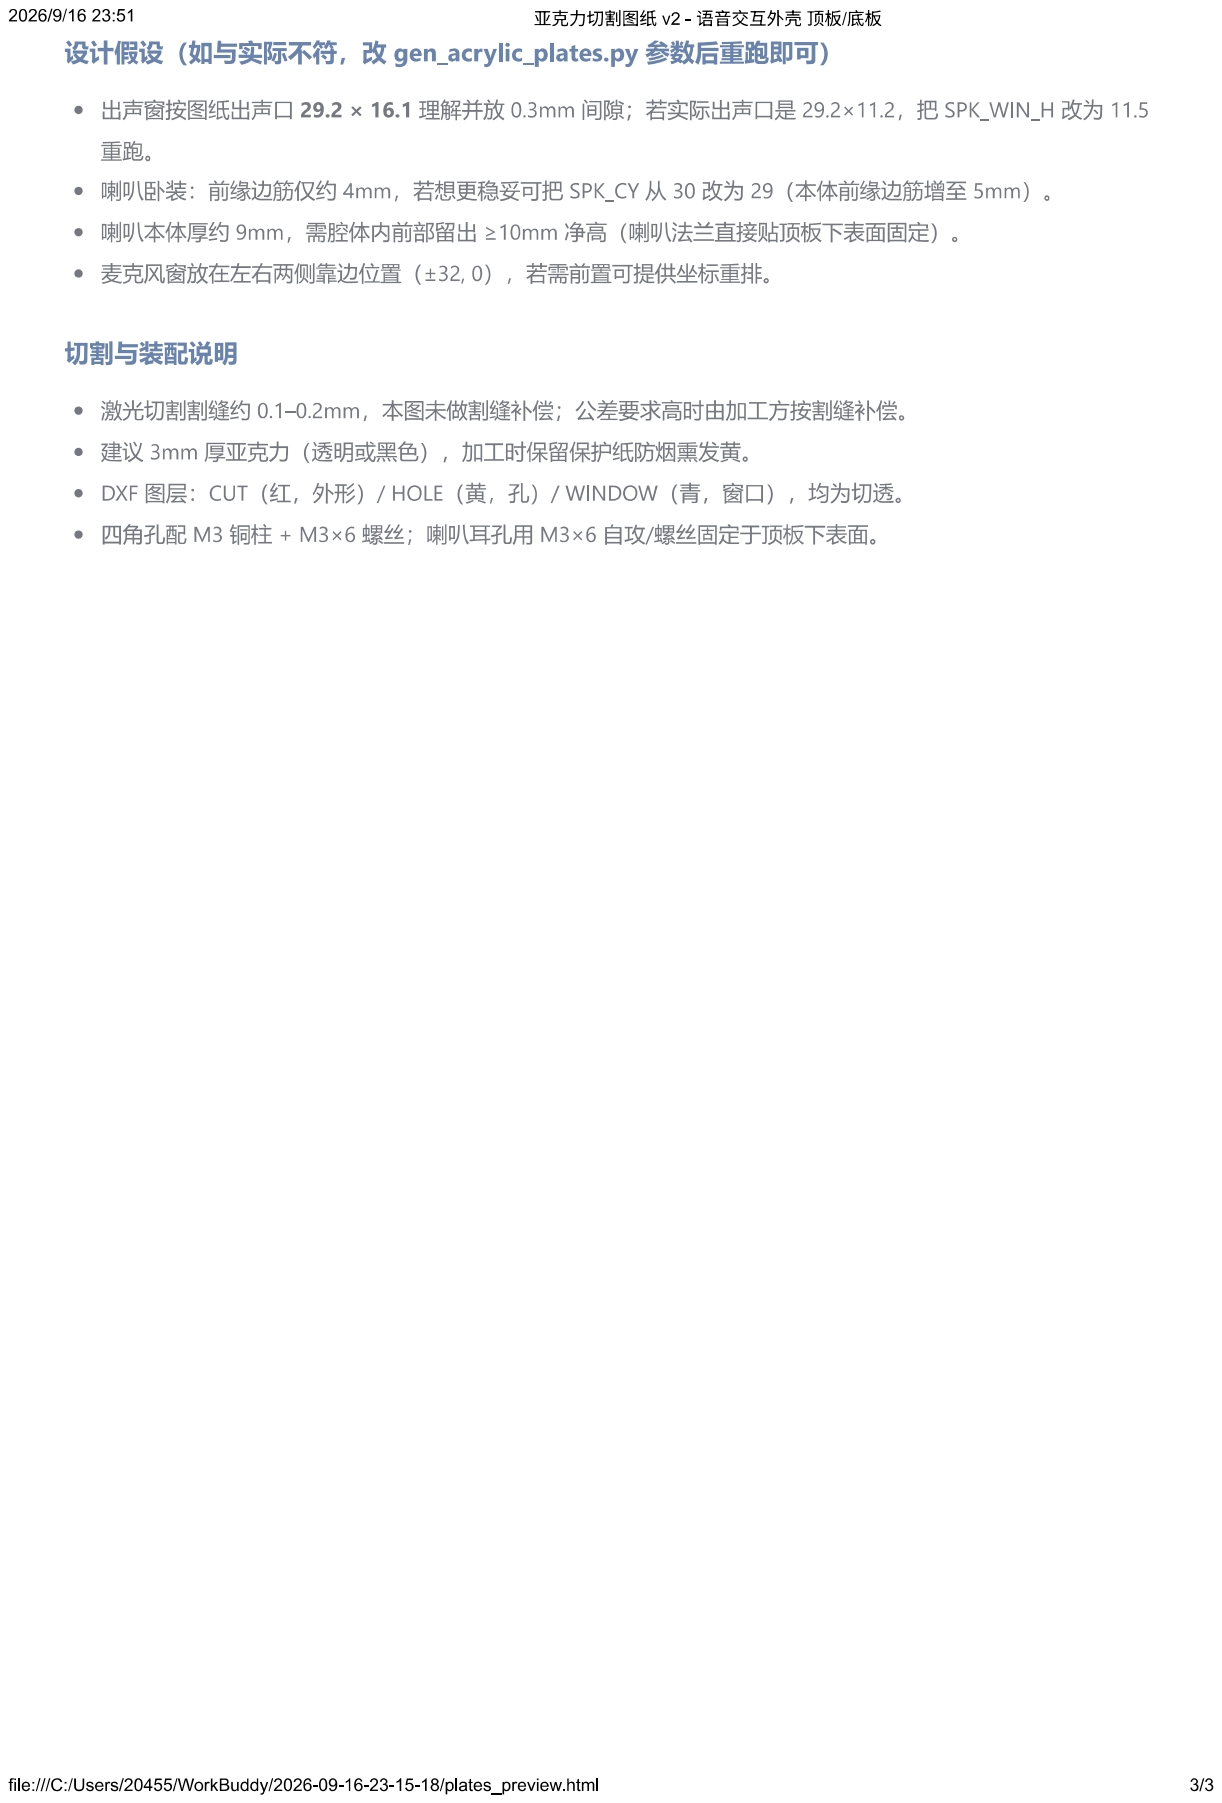
[picture p43: page 3]
