0422/DeskTalk/V2/desk_talk_idf/main/secrets.example.h

// 2026-09-19: Document local credentials required by the native ESP-IDF firmware without committing real secrets.
#pragma once

#define DEEPSEEK_API_KEY ""
#define VOLC_APP_ID ""
#define VOLC_ACCESS_TOKEN ""
#define VOLC_API_KEY ""
#define DEFAULT_WIFI_SSID ""
#define DEFAULT_WIFI_PASSWORD ""
