0422/DeskTalk/(commit log)

2026-08-23 add and edit：客户端断线后残留“已连接”状态；客户端控制表情时延迟大；修改固件使支持显示文本实现codex额度信息显示
2026-08-26 add:底座亚克力板结构图
    [acrylic_plates.dxf]
2026-09-14 edit on previous version, add some functions, restructed this project
    [Export3Dcover.FCStd, FriStackCore_bottom.stl, FriStackCore_lid.stl, acrylic_plates.dxf, partitions.csv]
2026-09-15 edit：整理了docs/
2026-09-18 edit：降低用户感知的首音频延迟
    [0,96'' OLED Display.step, 9G舵机.SLDPRT, 9G舵机.STEP, ESP32-S3-WROOM-1_devkit_2xUSBC.FCStd, ESP32-S3-WROOM-1_devkit_2xUSBC_c.step, Export3Dcover.FCStd, FriStackCore_bottom.stl, FriStackCore_lid.stl]
2026-09-20 add:迁移到ESP-IDF框架
    [partitions.csv]
2026-09-22 edit：重构 docs 目录结构，统一版本编号并全面修复文档问题
    - 目录重组：0-硬件文档 / 1-固件文档 / 2-外壳设计 / 3-开发流程 + 顶层四份总览文档
    - 版本编号统一：原 V4 更名 V3（端到端并行架构，规划中），原 V2+V3 合并为 V2
    - 修复断链、失实路径与目录树、文档间矛盾（上下文轮数、网关延迟、两套测试数据口径等）
    - 消除三重重冗余：以 1-固件文档/V2代码说明.md 为权威源，版本历史/待开发计划改为摘要+指针
    - 根 .gitignore 兜底忽略 secrets.h / *.env
    [0,96'' OLED Display.step, 9G舵机.SLDPRT, 9G舵机.STEP, ESP32-S3-WROOM-1_devkit_2xUSBC.FCStd, ESP32-S3-WROOM-1_devkit_2xUSBC_c.step, INMP441 I2S Microphone.SLDPRT, INMP441 I2S Microphone.STEP, M2.STEP]
2026-09-22 docs：补充许可证章节为 GPL-3.0（继承上游 desk-emoji）
2026-09-22 feat(v2): 优化流式对话链路并完善延迟测试文档
